trungKoiKa/Instrusion-Detect/docs/README.md

# docs

- `de_xuat_trien_khai_DATN_nhom17_12.md`: bản đề xuất triển khai (đọc file này).
- `tom_tat_trao_doi.md`: tóm tắt các câu hỏi, giải thích và quyết định khi trao đổi với Claude.
- Ghi kết quả đo (FPS, nhiệt độ, `v4l2-ctl --list-ctrls-menus`, ...) vào `docs/do_dac/` khi có.
