trungKoiKa/Instrusion-Detect/hardware/PCB_Layout/Schematic_New-Project_2026-10-15.pdf

# GNDLED_ALARM

# GNDLED_WARN

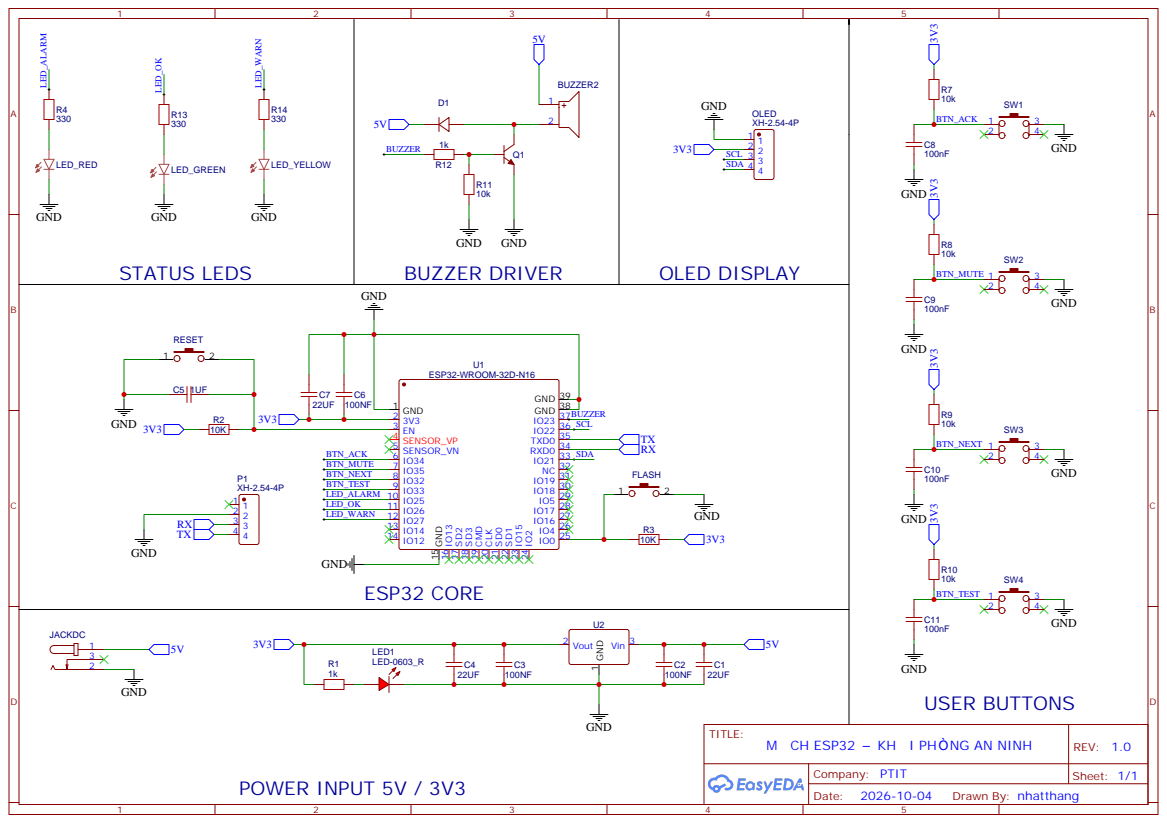
[picture p1: page 1]
