trungKoiKa/Instrusion-Detect/hardware/PCB_Layout/How-to-order-PCB.txt

How to Order PCB

Please refer to:
https://docs.easyeda.com/en/PCB/Order-PCB
