trungKoiKa/Instrusion-Detect/pi/tests/README.md

# tests

Mỗi kịch bản K1–K13 (mục 7 của đề xuất bản 12) có ít nhất một test. Dùng khung giả và thời gian giả, không cần camera hay MQTT thật.
