trungKoiKa/Instrusion-Detect/(commit log)

2026-10-31 Rút gọn bản đề xuất triển khai (bản 12)
    - Thay bản 8 bằng bản 12 trong docs/, khoảng 2.600 từ
    - 4 khu dọc theo góc nhìn thay cho ROI đa giác
    - Bỏ chế độ canh gác khỏi phạm vi chính, hai trục trạng thái
    - Fine-tune cho người xa, bị che, góc lạ, cúi/ngồi thay cho thiếu sáng
    - Cập nhật lại các mốc tiến độ
2026-10-31 Tạo cấu trúc thư mục dự án
    - docs/, config/, pi/, esp32/, tools/, ml/, deploy/, hardware/
    - README cho từng thư mục, ghi chức năng và người phụ trách
    - Khung module pi/safecam (file trống)
    - Chuyển PCB_Layout vào hardware/
    - .gitignore bỏ dữ liệu, model, log, mật khẩu
    [Drill_NPTH_Through.DRL, Drill_PTH_Through.DRL, Drill_PTH_Through_Via.DRL, Gerber_BoardOutlineLayer.GKO, Gerber_BottomLayer.GBL, Gerber_BottomSolderMaskLayer.GBS, Gerber_TopLayer.GTL, Gerber_TopPasteMaskLayer.GTP]
2026-10-31 Thêm CLAUDE.md: bối cảnh dự án và quy ước cho Claude Code
2026-10-31 Thêm tóm tắt trao đổi để Claude Code nắm bối cảnh
2026-10-31 Sửa hướng dẫn cài trên Pi: dùng torch bản CPU và TMPDIR trên thẻ nhớ
2026-10-31 Thêm file cấu hình camera và mô hình
2026-10-31 Mở camera và áp cấu hình MJPG 640x480 30 fps
2026-10-31 Luồng đọc camera: chỉ giải nén khi cần, timeout, tự mở lại
2026-10-31 Thêm bộ phát hiện người YOLO11n và script thử
2026-10-31 Thêm script đo FPS, CPU, RAM, nhiệt độ trên Pi
2026-10-31 Thêm script tóm tắt số liệu đo và vẽ biểu đồ
2026-10-31 docs: thêm sơ đồ kiến trúc hệ thống SafeCam
2026-10-31 docs: cập nhật phần hiện trạng trên sơ đồ kiến trúc
2026-10-31 docs: thêm quy tắc git pull đầu phiên vào CLAUDE.md
2026-10-31 docs: cập nhật số mục đề xuất bản 12 trong README của pi/ và pi/tests/
2026-11-10 docs: rút gọn kế hoạch dữ liệu và fine-tune
    - Thu ~10 video ngắn có đủ điều kiện khó và 1-2 video không người, ghi bằng ffmpeg
    - Gán nhãn trên CVAT, chia tập theo video thành train/val/test
    - Bỏ test_hard, test_external, trộn COCO, vòng mẫu âm khó riêng, YOLO11m gán sơ bộ, collect_data.py
    - Ghi lý do vào tóm tắt trao đổi, giữ YOLO11n
2026-11-10 docs: kế hoạch dữ liệu 6 video, tách ảnh bằng extract_frames.py
    - 6 video x 1 phút quay trong một ngày, mỗi video đổi ánh sáng và trang phục, vài giây đầu không người
    - Tách ảnh bằng tools/extract_frames.py --step 5 (~2.160 ảnh), chia theo video 4/1/1
    - Giữ augmentation mặc định của Ultralytics
    - Cập nhật CLAUDE.md, tóm tắt trao đổi, README của tools/ và ml/
